N00BMmika/Raspberrypi_pid_controlled_fan/Raspberrypi_pid_controlled_fan/bitmap/board_bottom_3d.PNG

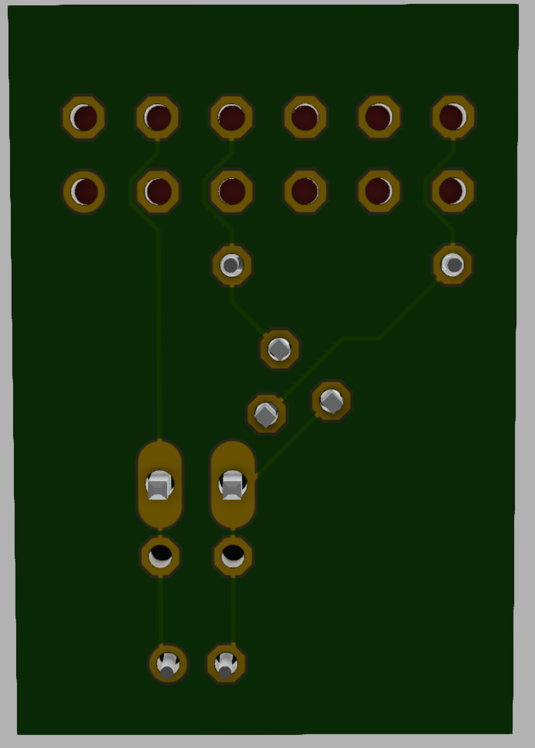
Raspberrypi_pid_controlled_fan/bitmap/board_bottom_3d.PNG
