N00BMmika/Raspberrypi_pid_controlled_fan/Raspberrypi_pid_controlled_fan/eagle/rpifan.brd

## EAGLE design Raspberrypi_pid_controlled_fan/eagle/rpifan.brd (2020-04-17)

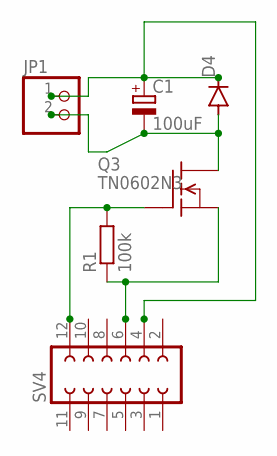
[picture p12: schematic rpifan.sch]

Parts:
C1: 100uF; E2-5
D4: DIODE-D-2.5; D-2.5
JP1: PINHD-1X2; 1X02
Q3: TN0602N3; TO-92
R1: 100k; 0204/7
SV4: FE06-2

Connections:
unnamed: Q3.2 (G), R1.2, SV4.12
unnamed: Q3.1 (S), R1.1, SV4.6
unnamed: C1.-, D4.A, JP1.2, Q3.3 (D)
unnamed: C1.+, D4.C, JP1.1, SV4.4

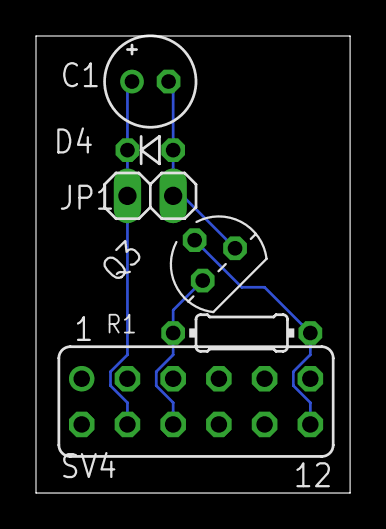
[picture p13: board rpifan.brd from above]

Board: 2 copper layers, 17.4 x 25.4 mm, 6 parts (0 on the bottom side), 4 nets.
